bitaggregat/bitMan/hardware/bitMan_BOM_2025_12_16.xlsx

No. | Quantity | Comment | Designator | Footprint | Value | Manufacturer Part | Manufacturer | Supplier Part | Supplier
1 | 1 | 2.9kHz | BUZZER1 | BUZ-TH_BD9.0-P5.00-D0.6-L-FD | 2.9kHz | Cy-9055-5029 | CY(超音) | C200211 | LCSC
2 | 1 | 4.7uF | C1 | C0603 | 4.7uF | CL10A475KO8NNNC | SAMSUNG(三星) | C19666 | LCSC
3 | 2 | 470nF | C2,C3 | C0603 | 470nF | CL10B474KA8NNNC | SAMSUNG(三星) | C1623 | LCSC
4 | 1 | 100nF | C4 | C0603 | 100nF | CC0603KRX7R9BB104 | YAGEO(国巨) | C14663 | LCSC
5 | 1 | ZX-HY2.0-4PWT | CN1 | CONN-SMD_4P-P2.00_ZX-HY2.0-4PWT |  | ZX-HY2.0-4PWT | Megastar(兆星) | C7429571 | LCSC
6 | 2 | BZT52C3V6 | D1,D2 | SOD-123_L2.7-W1.6-LS3.7-RD |  | BZT52C3V6 | R+O(宏嘉诚) | C19077397 | LCSC
7 | 3 | KT-0603R | LED1,LED3,LED4 | LED0603-RD |  | KT-0603R | KENTO | C2286 | LCSC
8 | 1 | TC3838RGBE07-3CJH-E19 | LED2 | LED-SMD_6P-L3.5-W3.5-BL |  | TC3838RGBE07-3CJH-E19 | TCWIN(天成) | C784547 | LCSC
9 | 2 | KT-0603G | LED5,LED6 | LED0603-RD |  | KT-0603G | KENTO | C12624 | LCSC
10 | 1 | 1.5kΩ | R1 | R0603 | 1.5kΩ | 0603WAF1501T5E | UNI-ROYAL(厚声) | C22843 | LCSC
11 | 2 | 68Ω | R2,R3 | R0603 | 68Ω | 0603WAF680JT5E | UNI-ROYAL(厚声) | C27592 | LCSC
12 | 3 | 300Ω | R4,R6,R9 | R0603 | 300Ω | 0603WAF3000T5E | UNI-ROYAL(厚声) | C23025 | LCSC
13 | 1 | 470Ω | R5 | R0603 | 470Ω | 0603WAF4700T5E | UNI-ROYAL(厚声) | C23179 | LCSC
14 | 1 | 680Ω | R7 | R0603 | 680Ω | 0603WAF6800T5E | UNI-ROYAL(厚声) | C23228 | LCSC
15 | 1 | 1kΩ | R8 | R0603 | 1kΩ | 0603WAF1001T5E | UNI-ROYAL(厚声) | C21190 | LCSC
16 | 2 | 2.2kΩ | R10,R11 | R0603 | 2.2kΩ | 0603WAF2201T5E | UNI-ROYAL(厚声) | C4190 | LCSC
17 | 2 | 5.1kΩ | R13,R14 | R0603 | 5.1kΩ | FRC0603F5101TS | FOJAN(富捷) | C2907044 | LCSC
18 | 1 | K2-1157SP-I4SW-01 | SW1 | SW-SMD_4P-L6.2-W6.2-P4.50-LS8.6 |  | K2-1157SP-I4SW-01 | 韩国韩荣 | C2909692 | LCSC
19 | 1 | ATMEGA328PB-AU | U3 | TQFP-32_L7.0-W7.0-P0.80-LS9.0-BL |  | ATMEGA328PB-AU | MICROCHIP(美国微芯) | C132230 | LCSC
20 | 1 | GT-USB-7010AN | U5 | USB-SMD_GT-USB-7010AN |  | GT-USB-7010AN | G-Switch(品赞) | C963370 | LCSC
