bitaggregat/bitMan/hardware/bitMan-Schematic.pdf

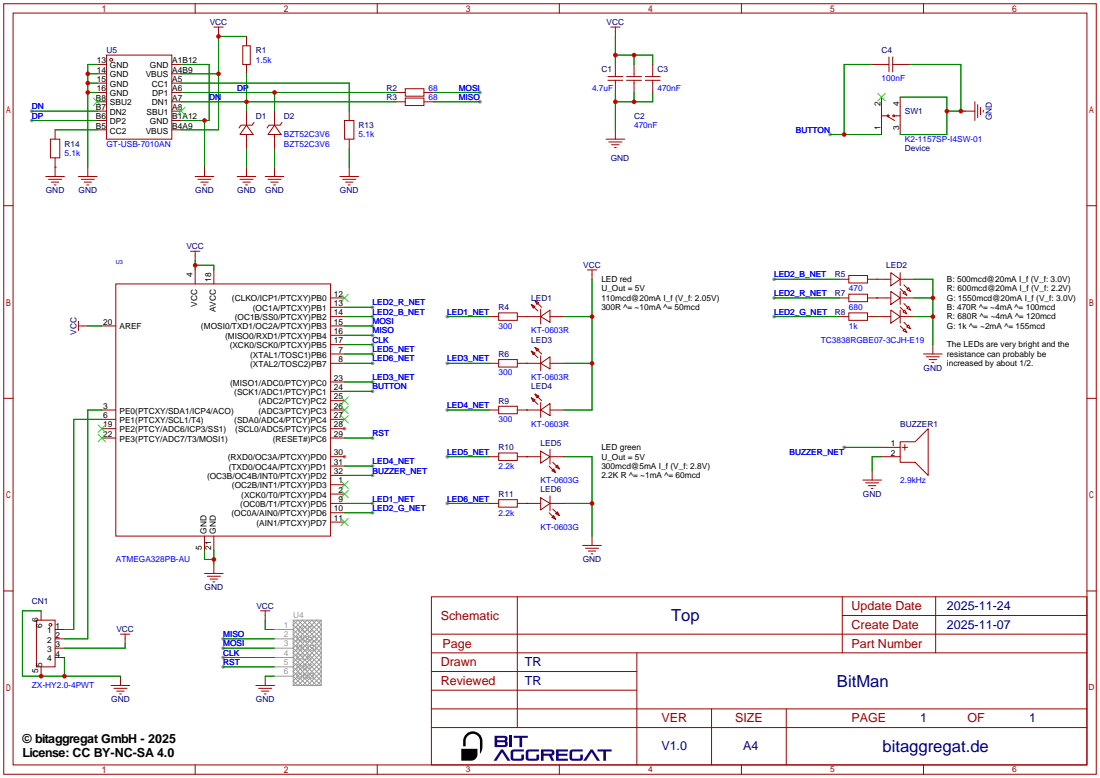
[picture p1: page 1]

© bitaggregat GmbH - 2025
License: CC BY-NC-SA 4.0
