bitaggregat/bitMan/(list of files, drawings)

Other design files:
hardware/bitMan_2025-12-16.epro
hardware/bitMan_PCB_2025-12-16.epro
hardware/bitMan_Schematic_2025-12-16.epro
